nammenam/Kuben/hardware/mechanical/flywheel.FCStd

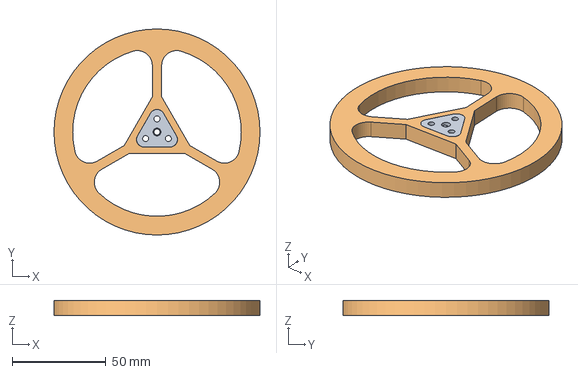
[picture p3: CAD file, 2026-05-23]
hardware/mechanical/flywheel.FCStd
110.0 x 110.0 x 8.00 mm
