nammenam/Kuben/hardware/mechanical/tmp/shaft_hub-Body.3mf

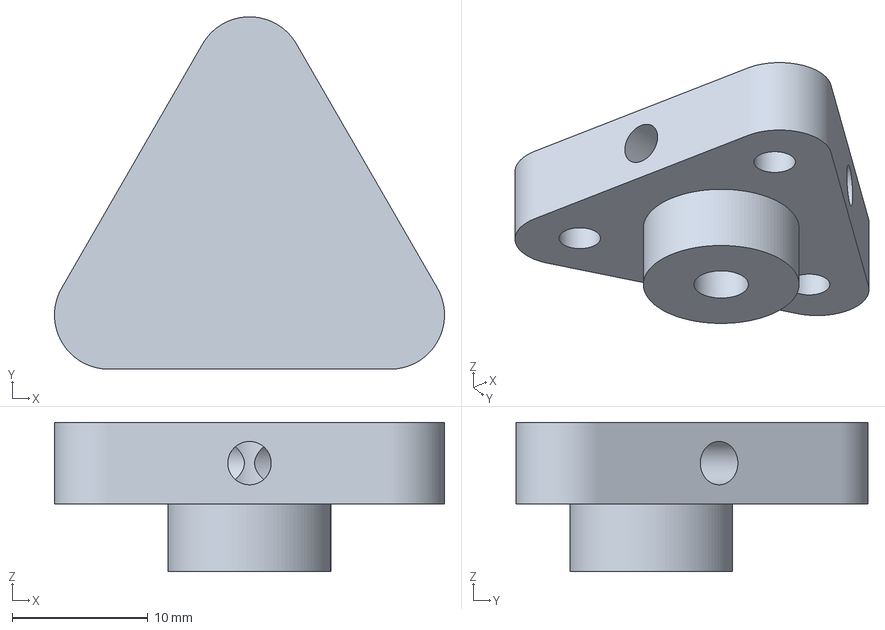
[picture p4: CAD file, 2026-05-23]
hardware/mechanical/tmp/shaft_hub-Body.3mf
28.8 x 26.0 x 11.0 mm
