nammenam/Kuben/hardware/mechanical/motordriverpcb.FCStd

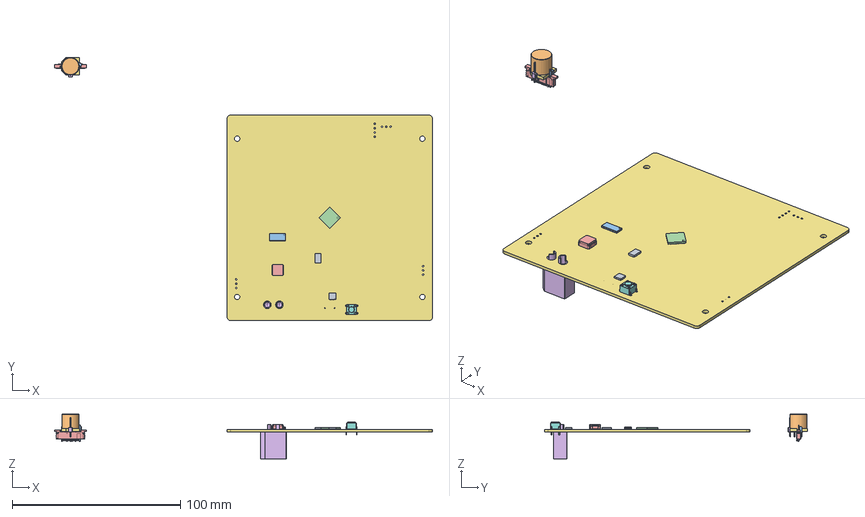
[picture p5: CAD file, 2026-05-23]
hardware/mechanical/motordriverpcb.FCStd
224.5 x 156.2 x 26.6 mm
R_0603_1608Metric
C_0603_1608Metric
IPD70P04P4L08ATMA2
ThermalPin
PinsArrayLR
PinsArrayTB
D_0603_1608Metric
Pins
BODY-TSSOP
LEAD-TSSOP
DAP
SOT-223
TMC4671-LA
SW_PUSH_6mm
ThermalPin001
PinsArrayLR001
PinsArrayTB001
IHLP2525CZER3R3M01
PinHeader_1x03_P2.54mm_Vertical
Base
Pin1Fillet
Pin2Fillet
IPD70P04P4L08ATMA003
59453-052110ECHLF
XT60-M
motordriver_PCB
