nammenam/Kuben/hardware/mechanical/tmp/flywheel-Body.3mf

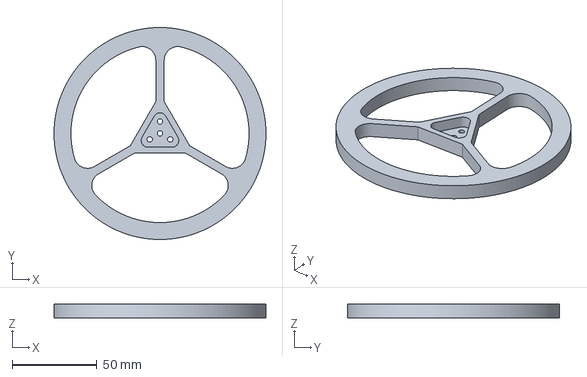
[picture p6: CAD file, 2026-05-23]
hardware/mechanical/tmp/flywheel-Body.3mf
125.0 x 125.0 x 8.00 mm
