nammenam/Kuben/hardware/mechanical/tmp/shaft_hub-Body_flat.3mf

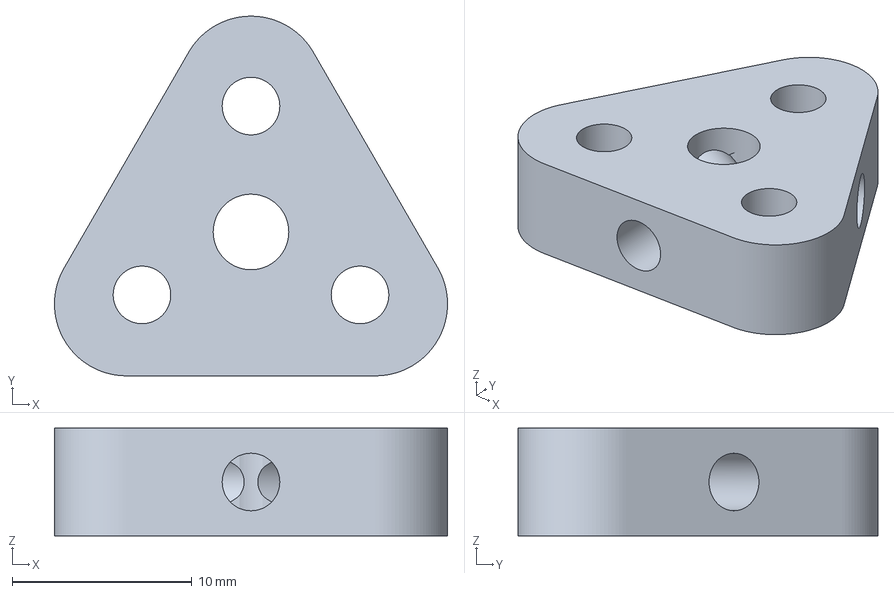
[picture p7: CAD file, 2026-05-23]
hardware/mechanical/tmp/shaft_hub-Body_flat.3mf
21.9 x 20.0 x 6.00 mm
