nammenam/Kuben/hardware/mechanical/cubeshell.FCStd

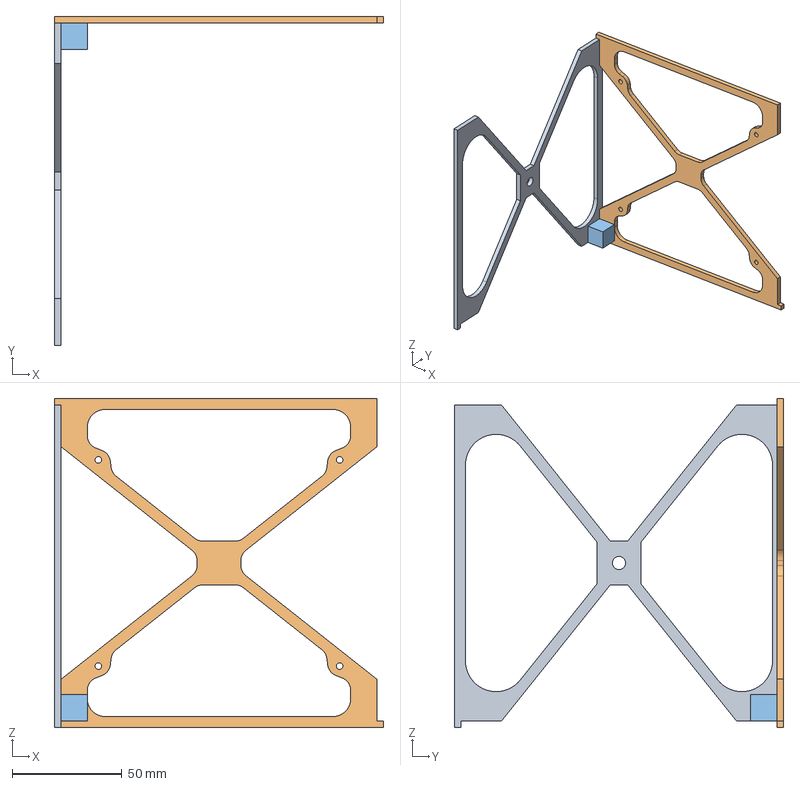
[picture p8: CAD file, 2026-05-23]
hardware/mechanical/cubeshell.FCStd
150.0 x 150.0 x 150.0 mm
