nammenam/Kuben/hardware/mechanical/motor.FCStd

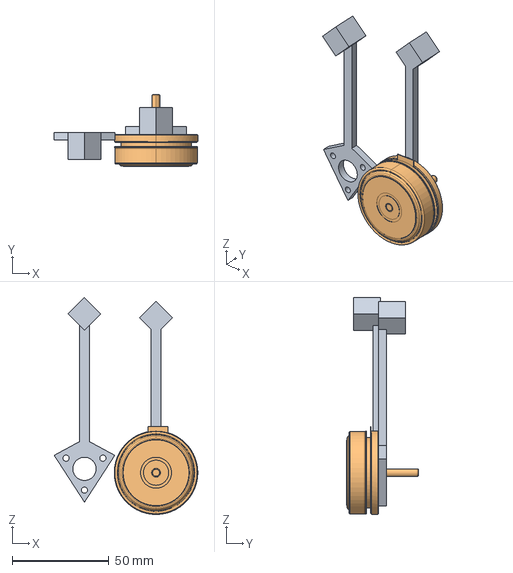
[picture p9: CAD file, 2026-05-23]
hardware/mechanical/motor.FCStd
74.3 x 37.0 x 112.2 mm
