nammenam/Kuben/hardware/mechanical/tmp/200142_EC45fl_30W_A.stp

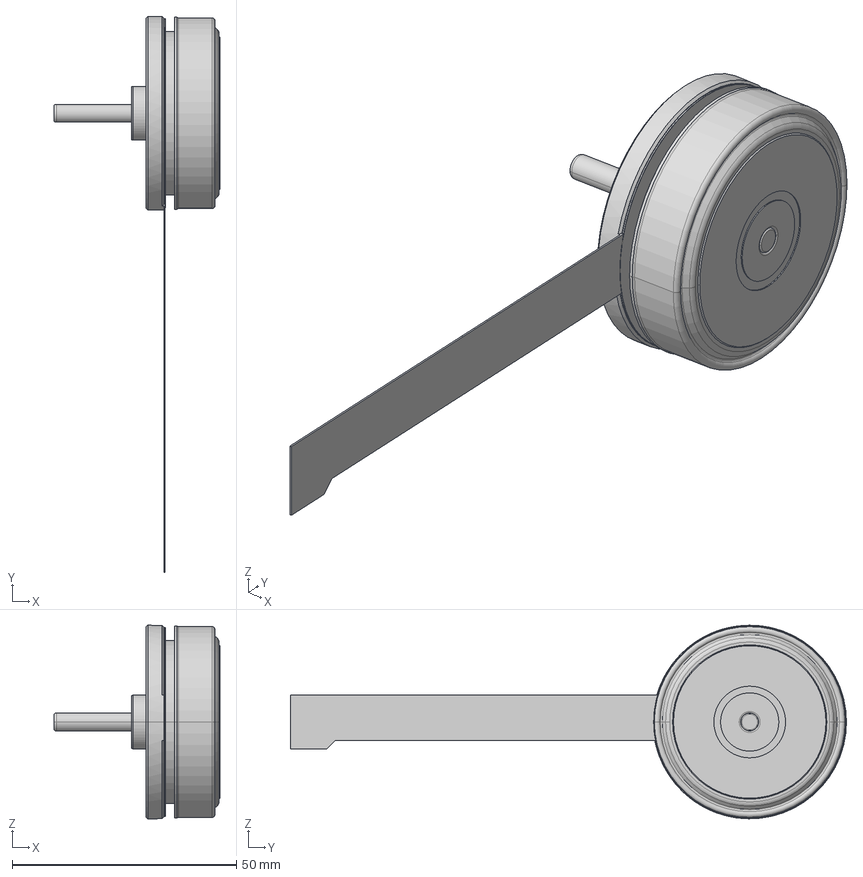
[picture p10: CAD file, 2026-05-23]
hardware/mechanical/tmp/200142_EC45fl_30W_A.stp
37.0 x 124.1 x 43.2 mm
