nammenam/Kuben/(list of files, cad)

Other CAD files:
hardware/mechanical/assembly.FCStd
hardware/mechanical/kuben-assembly.FCStd
