nammenam/Kuben/(commit log)

2026-05-23 added hardware
    [200142_EC45fl_30W_A.stp, assembly.FCStd, cubeshell.FCStd, flywheel-Body.3mf, flywheel.FCStd, kuben-assembly.FCStd, motor.FCStd, motordriverpcb.FCStd]
2026-06-04 small plans
    [ESCv1.1-B_Cu.gbl, ESCv1.1-B_Mask.gbs, ESCv1.1-B_Paste.gbp, ESCv1.1-B_SilkS.gbo, ESCv1.1-Edge_Cuts.gm1, ESCv1.1-F_Cu.gtl, ESCv1.1-F_Mask.gts, ESCv1.1-F_Paste.gtp]
