nammenam/Kuben/(notices)

Notices in the files:
hardware/electronics/bldcdriver/ESCv1.1.kicad_pcb:
©2021 runger
